hexeguitar/Enc2Btn/design files/Enc2Btn_schm.pdf

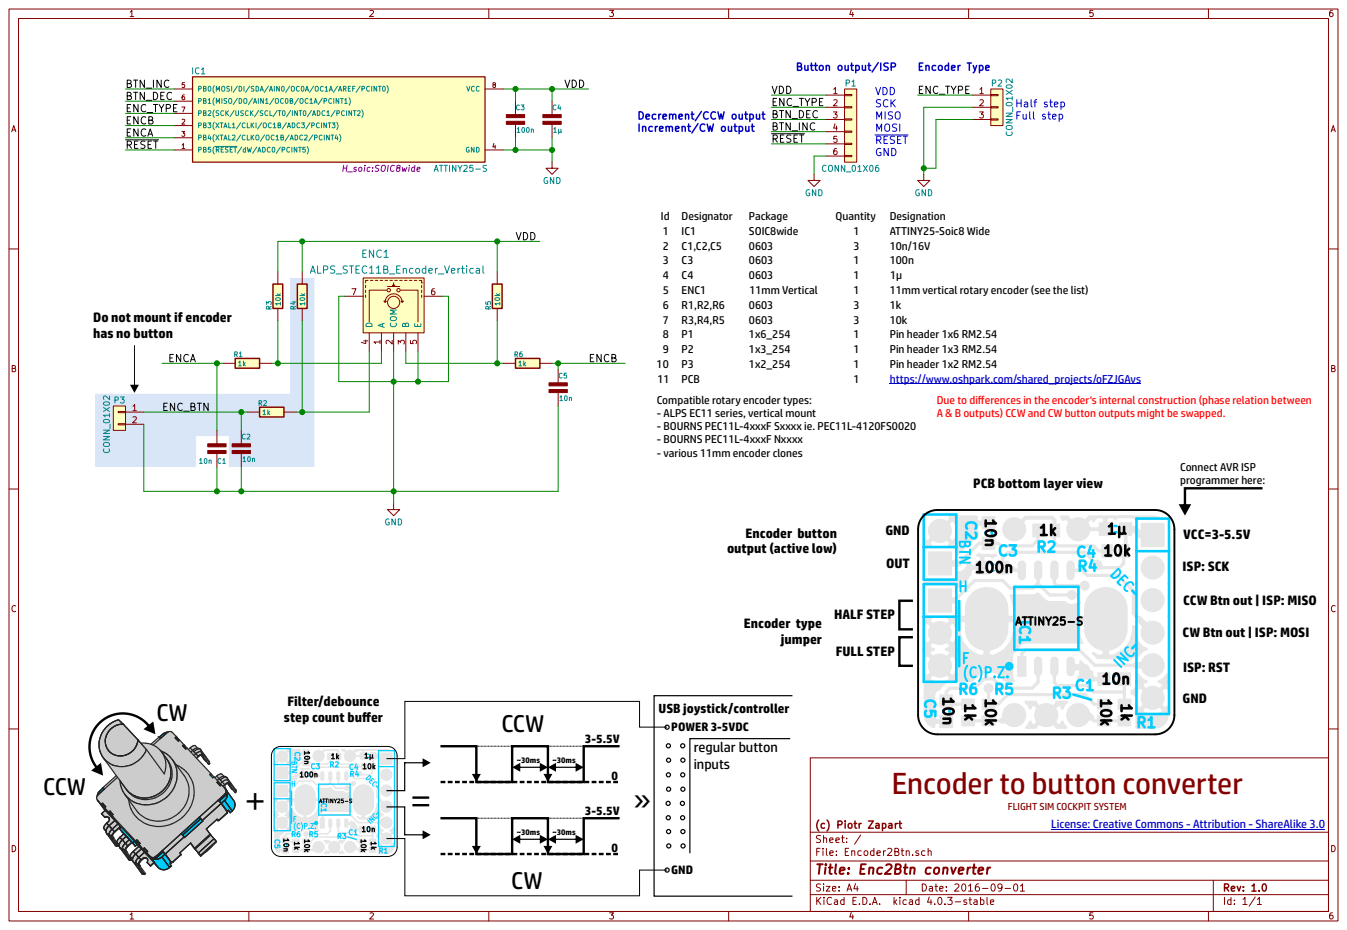
[picture p8: page 1]
CCW; USB joystick/controller; regular button inputs; VCC=3-5.5V; ISP: SCK; ISP: RST; GND; FULL STEP; HALF STEP; Encoder type jumper; OUT; Id Designator; Package; Quantity; Designation; SOIC8wide; ATTINY25-Soic8 Wide; 5 ENC1; 11mm Vertical; 11mm vertical rotary encoder (see the list); Pin header 1x6 RM2.54; Pin header 1x3 RM2.54; Pin header 1x2 RM2.54; 11 PCB; https://www.oshpark.com/shared_projects/oFZJGAvs; POWER 3-5VDC

Do not mount if encoder
has no button

Compatible rotary encoder types:
- ALPS EC11 series, vertical mount
- BOURNS PEC11L-4xxxF Sxxxx ie. PEC11L-4120FS0020
- BOURNS PEC11L-4xxxF Nxxxx
- various 11mm encoder clones

Due to differences in the encoder‘s internal construction (phase relation between
A & B outputs) CCW and CW button outputs might be swapped.

Connect AVR ISP
programmer here:

PCB bottom layer view

Encoder button
output (active low)

CCW Btn out | ISP: MISO

CW Btn out | ISP: MOSI

Filter/debounce
step count buffer

Encoder to button converter

FLIGHT SIM COCKPIT SYSTEM

License: Creative Commons - Attribution - ShareAlike 3.0 (http://creativecommons.org/licenses/by-sa/3.0/)
