hexeguitar/Enc2Btn/firmware/Enc2Btn/main.c

/*
 * Encoder to button converter
 * (c) 08-09 2016 Piotr Zapart
 * www.hexeguitar.com
 *
 * Converts CW and CCW encoder rotation into a constant width active low
 * "button press" events.
 * The main purpose of this module is to interface a rotary encoder
 * to two/three button inputs in USB joystick/DIY cockpit projects.
 *
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
 */


#include <avr/io.h>
#include <avr/interrupt.h>
#include <util/delay.h>
#include <avr/wdt.h>
#include "hardware/device.h"
#include "encoder/encoder.h"
#include "buttonOUT/button_out.h"



// ================================================================
int main(void)
{
	regEncoderEventCallback(buttonUpdate);
	hdwInit();
	setEncoder(0);
	/*
	 *
	 */
	pressPeriod_ms=63;

	sei();

	while(1)
	{
		wdt_reset();
		encoderEvent();
		buttonHandle();
	}

}

// END
